GabbedT/ZenithSoC/ROADMAP.md

# ZenithSoC Roadmap 

The project will be developed using an incremental approach, structured into four distinct phases. Each phase builds upon the functionality established in the preceding step, progressively enhancing the platform capabilities. Notably, these phases are designed to be modular, allowing for any configuration to operate independently without dependency on subsequent additions. Here’s the phased development plan:

## Roadmap 

* Implement successfully in FPGA ✅
* Run real benchmark on it ✅
* Run Fractal with VGA output ✅
* Run DOOM?

### Project Structure

* Delete relative path and substitute with .f file ✅
* Add CPU cosimulation with Spike ✅

* Update documentation on ZenithSoC and ApogeoRV

* Update examples

### Testing

* Improve Python generator ✅

* Add a verilator testbench for fast software testing ✅

* Verify again every block extensively with SW driven tests thanks to Virtual Platform ✅

* Trace Unit design and verification

* C extension verification ✅
* Zfinx extension verification ✅
* CPU level test interrupts verification ✅
* SoC level interrupt verification ✅
* WFI instruction with verification
* Exception verification
* Privilege level verification

### Benchmark & Performance

* Coremark porting for SoC ✅
* Run Coremark on verilator testbench and extract performance ✅
* Embench-IoT porting for SoC ✅

* Improve performances on ApogeoRV ✅

### Bugfix

* Embench-IoT bug on huffbench as test FAIL ✅
* Fix bugs in Cache Complex ✅
* Fix C extension bugs ✅
* Fix Zfinx extension bugs ✅

### Design

* Add FENCE.I
* Add fused FPU instructions

* Add VGA ✅
* Modify ddr interface to accomodate 2 masters ✅
* Re-analyze and upgrade AXI bus
* Add external slave port for AXI bus
* Add external interrupts
* I2C design and verification
* GPU design
