GabbedT/ZenithSoC/docs/peripherals/trace_unit.rst

Trace Unit
==========

Overview
--------

The Trace Unit is a hardware module for real-time debugging and profiling of the RISC-V processor core. It monitors core execution by capturing events (exceptions, system calls, memory operations) and branch divergence (jumps, branches, calls), generating trace packets transmitted via UART for offline analysis.

The module operates non-intrusively with minimal overhead on core execution, supporting 24-bit timestamps, PC-based triggers, and configurable buffering to handle event bursts.

Features
~~~~~~~~

* CPU event tracing (exceptions, interrupts, system calls, memory operations)
* Branch divergence tracing (non-sequential control flow)
* 24-bit timestamp for temporal correlation
* Program Counter trigger for selective tracing start
* Configurable packet FIFO (32 entries in the current SoC integration)
* Automatic serialization to UART
* Core halting on buffer full to prevent data loss
* Interrupt on buffer full/empty

Architecture
------------

The Trace Unit consists of three main modules:

* **Registers**: Manages configuration, control and status registers
* **Packetizer**: Generates trace packets from CPU events and divergence detection
* **Serializer**: Serializes packets into byte stream to UART

Signal interface
~~~~~~~~~~~~~~~~

Port directions are relative to the ``trace_unit`` module. The register
signals are the local SoC memory-mapped interface, while the CPU and UART
signals are sideband interfaces. Addresses are 2-bit word indices and
``write_strobe_i`` enables individual bytes of ``write_data_i``.

.. list-table:: Trace Unit module signals
   :header-rows: 1
   :widths: 32 12 14 42

   * - Signal
     - Direction
     - Width
     - Description
   * - ``clk_i``
     - Input
     - 1
     - System clock.
   * - ``rst_n_i``
     - Input
     - 1
     - Active-low reset.
   * - ``write_i`` / ``read_i``
     - Input
     - 1 each
     - Register write and read requests.
   * - ``write_address_i[1:0]`` / ``read_address_i[1:0]``
     - Input
     - 2 each
     - Word indices in the Trace Unit register window.
   * - ``write_data_i[31:0]``
     - Input
     - 32
     - Register write data.
   * - ``write_strobe_i[3:0]``
     - Input
     - 4
     - Byte write enables.
   * - ``write_done_o`` / ``read_done_o``
     - Output
     - 1 each
     - Register transaction completion responses.
   * - ``write_error_o`` / ``read_error_o``
     - Output
     - 1 each
     - Invalid register access responses.
   * - ``interrupt_o``
     - Output
     - 1
     - Configured buffer interrupt request.
   * - ``halt_core_o``
     - Output
     - 1
     - Stops the CPU while the packet buffer is full.
   * - ``trace_interface_i``
     - Input
     - Interface
     - CPU trace bundle: ``valid``, ``address[31:0]`` and ``info``.
   * - ``uart_tx_full_i``
     - Input
     - 1
     - Backpressure from the UART TX FIFO.
   * - ``trace_chunk_o[7:0]``
     - Output
     - 8
     - Serialized trace byte sent to the UART.
   * - ``write_chunk_o``
     - Output
     - 1
     - One-cycle valid/write strobe for ``trace_chunk_o``.

Operation
---------

Packet Types
~~~~~~~~~~~~

The packetizer stores a fixed 64-bit packet internally. The serializer sends
the most-significant byte first (``raw[7]`` through ``raw[0]``), and emits only
the bytes required by the packet type. Protocol v2 prefixes every packet with
``0x1E`` (ASCII Record Separator). Within the packet body, ``0x1E`` and ``0x1D``
are escaped as ``0x1D`` followed by the original byte XOR ``0x20``. The UART
applies the same escaping to CPU console bytes, so unescaped ``0x1E`` is reserved
for trace synchronization. Packet bodies are serialized atomically; a separate
CPU queue retains concurrent console writes subject to its normal full flag.

The byte layouts below describe unescaped bodies, excluding the sync prefix.
The two most-significant bits of body byte 0 identify the packet type:

.. list-table:: Packet type codes
   :header-rows: 1
   :widths: 20 18 62

   * - Code
     - Name
     - Meaning
   * - ``2'b00``
     - ``EVENT_PACKET``
     - A selected CPU event identified by the six-bit event number.
   * - ``2'b01``
     - ``DIVERGENCE_PACKET``
     - A non-sequential PC transition.
   * - ``2'b10``
     - ``OVERFLOW_PACKET``
     - The 24-bit timestamp counter wrapped.
   * - ``2'b11``
     - ``START_PACKET``
     - Absolute initial PC or a new branch tracing session.

Start packet
^^^^^^^^^^^^

When branch tracing first accepts a valid PC (matching the trigger if enabled),
it queues a START before subsequent divergence packets. Disabling and re-enabling
branch tracing rearms START. Its body is always five bytes, without a timestamp:

.. code-block:: text

   byte 0: 11000000 (0xC0)
   byte 1..4: absolute PC[31:0], most-significant byte first

The last-reported-PC reference changes only when a START or divergence packet
is accepted into the packet FIFO. Sequential retired instructions do not change
this reference. They still update the separate previous-retired-PC register used
to detect divergences. Event-only tracing does not emit START packets.

Event packet
^^^^^^^^^^^^

The event number is copied from ``trace_interface_i.info``. The timestamp is
the 24-bit packetizer counter at packet creation time. The byte layout on the
UART stream is:

.. code-block:: text

   Without timestamp (1 byte):
   byte 0: [7:6] packet type = 00 | [5:0] event number

   With timestamp (4 bytes):
   byte 0: [7:6] packet type = 00 | [5:0] event number
   byte 1: timestamp[23:16]
   byte 2: timestamp[15:8]
   byte 3: timestamp[7:0]

Divergence packet
^^^^^^^^^^^^^^^^^

The packetizer compares the current valid PC with the previous valid PC. The
``delta_pc`` field is the signed 32-bit two's-complement value
``current_pc - last_reported_pc``. ``last_reported_pc`` is the address represented
by the preceding successfully queued START/divergence packet, not the previous
retired instruction. The byte layout is:

.. code-block:: text

   Without timestamp (5 bytes):
   byte 0: [7:6] packet type = 01 | [5:0] reserved = 0
   byte 1: delta_pc[31:24]
   byte 2: delta_pc[23:16]
   byte 3: delta_pc[15:8]
   byte 4: delta_pc[7:0]

   With timestamp (8 bytes):
   byte 0: [7:6] packet type = 01 | [5:0] reserved = 0
   byte 1..4: delta_pc[31:0], most-significant byte first
   byte 5: timestamp[23:16]
   byte 6: timestamp[15:8]
   byte 7: timestamp[7:0]

Overflow packet
^^^^^^^^^^^^^^^

The overflow packet is one byte:

.. code-block:: text

   byte 0: [7:6] packet type = 10 | [5:0] reserved = 0

It is queued when the timestamp reaches ``24'hFFFFFF``. If an event or
divergence packet is created in the same cycle, that packet has priority and
the overflow notification is held pending for a later cycle.

Timestamp framing
^^^^^^^^^^^^^^^^^

The serializer's ``enable_timestamp_i`` input is the OR of the event and
branch timestamp controls. Therefore, when either timestamp control is set,
both event and divergence packets are serialized with their three-byte
timestamp field. The timestamp is still present in the internal packet when
timestamping is disabled; it is simply omitted from the UART stream.

Event Tracing
~~~~~~~~~~~~~

When enabled, the Trace Unit captures configurable events from the core:

* **Instruction faults**: Misaligned, access fault, illegal instruction
* **Breakpoint**: Debug breakpoint
* **Load/Store operations**: Memory operations and related faults
* **System calls**: User-mode and machine-mode ecall
* **Handler return**: MRET instruction
* **Sleep**: WFI instruction
* **Branch/Jump**: Control flow operations
* **CSR operations**: Control Status Register accesses

Branch Tracing
~~~~~~~~~~~~~~

The module compares the current PC with the previous one. If it is not
``previous_pc + 4``, ``previous_pc + 2`` for a compressed instruction, or the
same PC, it generates a divergence packet containing the PC delta.

Divergence detection activates after START is queued for the first valid PC
(or the trigger PC). Packet priority is START, divergence, event, then overflow.
Only one packet is queued per cycle, so a coincident event may be suppressed.

Timestamp
~~~~~~~~~

The 24-bit counter increments every cycle when timestamping is enabled. Upon reaching 0xFFFFFF, it generates an Overflow Packet and continues from 0.

Trigger PC
~~~~~~~~~~

When enabled, branch tracing starts only when the core reaches the specified PC. Useful for tracing specific code sections.

Core Halting
~~~~~~~~~~~~

When the buffer is full, the ``halt_core_o`` signal is asserted to stop the core and prevent packet loss. The core resumes when buffer space becomes available.

Serializer FSM
--------------

The serializer uses IDLE, SYNC, DATA and ESCAPED states. IDLE reads the
synchronous packet FIFO. SYNC latches that packet, snapshots its body length
and emits ``0x1E``. DATA emits ordinary body bytes or ``0x1D`` for a reserved
byte; ESCAPED emits that byte XOR ``0x20``. It returns to IDLE after the last
body byte. UART backpressure preserves the current byte and state.

START always has five body bytes. OVERFLOW has one. EVENT has one or four;
DIVERGENCE has five or eight, according to the timestamp enable OR. Timestamp
settings must remain stable throughout a capture because no mode flag is sent.
The trace status empty flag includes serializer activity as well as the FIFO,
so software cannot mistake an in-flight packet for a fully drained trace buffer.

Register Map
------------

+--------+----------------+------+-----------------------------------------------+
| Offset | Register       | R/W  | Description                                   |
+========+================+======+===============================================+
| 0x00   | STATUS         | R    | Status register (buffer full/empty)           |
+--------+----------------+------+-----------------------------------------------+
| 0x04   | CONTROL        | R/W  | Control register (enable tracing, interrupts) |
+--------+----------------+------+-----------------------------------------------+
| 0x08   | EVENT_ENABLE   | R/W  | Event enable mask                             |
+--------+----------------+------+-----------------------------------------------+
| 0x0C   | PC_TRIGGER     | R/W  | Trigger PC value                              |
+--------+----------------+------+-----------------------------------------------+

Register Descriptions
~~~~~~~~~~~~~~~~~~~~~

**STATUS (Offset: 0x00)**

+--------+-------------+-----+-----------------------------------------------+
| Bit    | Field       | R/W | Description                                   |
+========+=============+=====+===============================================+
| 0      | BUFFER_EMPTY| R   | Buffer empty (1 = empty, 0 = data present)    |
+--------+-------------+-----+-----------------------------------------------+
| 1      | BUFFER_FULL | R   | Buffer full (1 = full, 0 = space available)   |
+--------+-------------+-----+-----------------------------------------------+
| 31:2   | Reserved    | R   | Reserved (read as 0)                          |
+--------+-------------+-----+-----------------------------------------------+

*Reset Value:* 0x00000001 (buffer empty)

**CONTROL (Offset: 0x04)**

+--------+------------------------+-----+-----------------------------------------------+
| Bit    | Field                  | R/W | Description                                   |
+========+========================+=====+===============================================+
| 0      | ENABLE_EVENT_TRACING   | R/W | Enable event tracing                          |
+--------+------------------------+-----+-----------------------------------------------+
| 1      | ENABLE_BRANCH_TRACING  | R/W | Enable branch divergence tracing              |
+--------+------------------------+-----+-----------------------------------------------+
| 2      | ENABLE_TIMESTAMP_EVENT | R/W | Include timestamp in event packets            |
+--------+------------------------+-----+-----------------------------------------------+
| 3      | ENABLE_TIMESTAMP_BRANCH| R/W | Include timestamp in divergence packets       |
+--------+------------------------+-----+-----------------------------------------------+
| 4      | ENABLE_TRIGGER         | R/W | Enable PC trigger for branch tracing          |
+--------+------------------------+-----+-----------------------------------------------+
| 5      | CLEAR_TIMESTAMP        | W   | Clear timestamp counter (self-clearing)       |
+--------+------------------------+-----+-----------------------------------------------+
| 6      | ENABLE_INT_FULL        | R/W | Enable interrupt on buffer full               |
+--------+------------------------+-----+-----------------------------------------------+
| 7      | ENABLE_INT_EMPTY       | R/W | Enable interrupt on buffer empty              |
+--------+------------------------+-----+-----------------------------------------------+
| 31:8   | Reserved               | R   | Reserved (read as 0)                          |
+--------+------------------------+-----+-----------------------------------------------+

*Reset Value:* 0x00000000

**EVENT_ENABLE (Offset: 0x08)**

18-bit mask to enable specific events. Each bit corresponds to an event:

+--------+-----------------------+-----+---------------+-----------------------------------------------+
| Bit    | Event                 | R/W | Event Number  | Description                                   |
+========+=======================+=====+===============+===============================================+
| 0      | INSTR_MISALIGNED      | R/W | 0             | Instruction address misaligned                |
+--------+-----------------------+-----+---------------+-----------------------------------------------+
| 1      | INSTR_ACCESS_FAULT    | R/W | 1             | Instruction access fault                      |
+--------+-----------------------+-----+---------------+-----------------------------------------------+
| 2      | INSTR_ILLEGAL         | R/W | 2             | Illegal instruction                           |
+--------+-----------------------+-----+---------------+-----------------------------------------------+
| 3      | BREAKPOINT            | R/W | 3             | Breakpoint exception                          |
+--------+-----------------------+-----+---------------+-----------------------------------------------+
| 4      | LOAD_OPERATION        | R/W | 19            | Load operation executed                       |
+--------+-----------------------+-----+---------------+-----------------------------------------------+
| 5      | LOAD_MISALIGNED       | R/W | 4             | Load address misaligned                       |
+--------+-----------------------+-----+---------------+-----------------------------------------------+
| 6      | LOAD_ACCESS_FAULT     | R/W | 5             | Load access fault                             |
+--------+-----------------------+-----+---------------+-----------------------------------------------+
| 7      | STORE_OPERATION       | R/W | 18            | Store operation executed                      |
+--------+-----------------------+-----+---------------+-----------------------------------------------+
| 8      | STORE_MISALIGNED      | R/W | 6             | Store address misaligned                      |
+--------+-----------------------+-----+---------------+-----------------------------------------------+
| 9      | STORE_ACCESS_FAULT    | R/W | 7             | Store access fault                            |
+--------+-----------------------+-----+---------------+-----------------------------------------------+
| 10     | U_SYSTEM_CALL         | R/W | 8             | User-mode system call (ecall)                 |
+--------+-----------------------+-----+---------------+-----------------------------------------------+
| 11     | M_SYSTEM_CALL         | R/W | 11            | Machine-mode system call (ecall)              |
+--------+-----------------------+-----+---------------+-----------------------------------------------+
| 12     | HANDLER_RETURN        | R/W | 17            | Interrupt handler return (mret)               |
+--------+-----------------------+-----+---------------+-----------------------------------------------+
| 13     | SLEEP                 | R/W | 16            | Core sleep (WFI)                              |
+--------+-----------------------+-----+---------------+-----------------------------------------------+
| 14     | BRANCH                | R/W | 20            | Branch instruction executed                   |
+--------+-----------------------+-----+---------------+-----------------------------------------------+
| 15     | JUMP                  | R/W | 21            | Jump instruction executed                     |
+--------+-----------------------+-----+---------------+-----------------------------------------------+
| 16     | CSR                   | R/W | 22            | CSR operation                                 |
+--------+-----------------------+-----+---------------+-----------------------------------------------+
| 31:17  | Reserved              | R   | -             | Reserved (read as 0)                          |
+--------+-----------------------+-----+---------------+-----------------------------------------------+

*Reset Value:* 0x00000000

**PC_TRIGGER (Offset: 0x0C)**

+--------+-------+-----+-----------------------------------------------+
| Bit    | Field | R/W | Description                                   |
+========+=======+=====+===============================================+
| 31:0   | VALUE | R/W | Program Counter trigger value                 |
+--------+-------+-----+-----------------------------------------------+

*Reset Value:* 0x00000000

Timing Characteristics
----------------------

* **Timestamp resolution**: 1 clock cycle
* **Timestamp range**: 0 to 16,777,215 cycles (24-bit)
* **Packet generation latency**: 1 clock cycle
* **Serialization rate**: Limited by UART TX speed
* **Buffer depth**: Configurable (32 packets in the current SoC integration)

For a 50 MHz clock:

* **Timestamp resolution**: 20 ns
* **Timestamp overflow**: ~335 ms
* **Max sustained event rate**: Depends on UART baud rate

Integration Guidelines
----------------------

UART Connection
~~~~~~~~~~~~~~~

The Trace Unit connects directly to the UART TX buffer. The ``uart_tx_full_i`` signal handles backpressure when UART cannot accept data.

Core Halting
~~~~~~~~~~~~

When the buffer is full, ``halt_core_o`` stops the core to prevent packet loss. Ensure the core supports halting via this signal.

Buffer Sizing
~~~~~~~~~~~~~

Buffer size must be chosen based on:

* Expected event rate
* UART baud rate
* Core halting tolerance

A larger buffer reduces core halt probability but increases latency and area.

Packet Parsing
~~~~~~~~~~~~~~

1. Route bytes outside frames to the console, reversing console escapes.
2. On unescaped ``0x1E``, begin a trace packet and reverse body escapes.
3. Obtain the body length from its type and the configured timestamp mode.
4. START establishes the absolute PC. Add each divergence delta modulo 2^32
   to the last reported PC; resolve that address through an ELF if available.
5. Events have no address and do not update the PC reference.
6. An unexpected sync byte can recover framing after corruption. Invalidate
   the PC reference until a new START because a missing delta cannot be inferred.

This reconstructs reported PC samples, not every retired instruction. START has
no timestamp. Without a checksum or sequence number, some corruption and loss of
whole packets cannot be detected. Capture before firmware enables branch tracing
to receive START; an already running stream may require tracing to be restarted.
Legacy unframed v1 captures use a different decoder and delta reference.

Limitations
-----------

* 24-bit timestamp (overflow after ~335 ms at 50 MHz)
* Fixed buffer size at synthesis time
* No packet compression
* Single trace interface (only one core supported)
* Shared UART console/trace requires a v2-aware decoder (legacy captures remain v1)
* Core halting on buffer full may impact real-time timing
