GabbedT/ZenithSoC/fpga/nexys_a7/README.md

# Nexys A7 DDR Vivado flow

The batch flow targets the Digilent Nexys A7 DDR 100T
(`xc7a100tcsg324-1`) with Vivado 2024.1.

```bash
cd fpga/nexys_a7
make project       # create the project and regenerate IP
make retry-synth   # rerun RTL synthesis while reusing generated IP
make retry-impl    # rerun implementation from the synthesized checkpoint
make finish-routed # write reports/bitstream from an existing routed checkpoint
make synth         # synthesize
make impl          # place and route
make bitstream     # generate build/vivado/ZenithSoC_nexys_a7.bit
make update-bootloader # patch a new bootloader into an existing bitstream
make sim           # run the accurate MIG + DDR2 + SD-card XSim testbench
make sim_gui       # open the simulation in the Vivado GUI
make wave          # open the captured waveform database in XSim
```

To open the project manually, use `build/vivado/project/ZenithSoC.xpr` after
running `make project`. In Vivado select **Simulation Sources**, verify
`soc_testbench` as the simulation top, then choose **Run Simulation > Run
Behavioral Simulation**. The generated project now contains the MIG, DDR2,
SD-card model, testbench, and SD image in `sim_1`.

The simulation target uses the generated clock wizard and MIG controller, the
Micron DDR2 component model in `tb/ddr_model`, and the SD-card model maintained
in `vp/blocks/sd/rtl`.  Testbench sources are added explicitly to the Vivado
simulation fileset; `SoC_testbench.sv` therefore contains no source includes or
machine-specific paths.  The default simulated interval is 1 ms and can be
overridden, for example:

```bash
make sim SIM_RUNTIME=5ms JOBS=8
```

For the VGA fractal image, build the application and pass both generated
initialization files explicitly:

```bash
make -C sw/examples/vga VGA_DEMO=fractal RESOLUTION=320x240 all
make -C fpga/nexys_a7 sim SIM_RUNTIME=20ms JOBS=4 \
    VIVADO=/tools/Xilinx/2026.1/Vivado/bin/vivado \
    BOOTLOADER_HEX=../../sw/examples/vga/out/boot.hex \
    SD_IMAGE_HEX=../../sw/examples/vga/out/vga_fractal_sd_words.hex
```

The VGA Makefile converts `program.bin` to one 32-bit hexadecimal word per
line for the SD-card model. The simulation Tcl stages the selected boot image
under the canonical `bootloader.hex` name expected by the SoC ROM and adds the
selected SD image to the XSim memory fileset.

`make sim_gui` uses the same project and waveform setup but leaves the
simulation open for interactive use.  After a batch run, `make wave` creates a
curated waveform configuration and opens the captured database; it requires a
previous `make sim` run. Preferrebly one should do a `make sim_gui`, add the required signals
and save the waveform file, then exit and execute `make sim`.

The XSim project, log, waveform database, and trace files are written below
`build/vivado/simulation/`.  The simulation define set intentionally includes
`_VIVADO_` and excludes `VERILATOR`, so `ZenithSoC` instantiates the real MIG
path rather than its fast behavioural DDR replacement.

The simulation depends on the boot image and sine-table
initialization file configured in `project_config.tcl`, from here change the bootloader hex path.  Build those images
before running XSim if they are not already present.

Override the executable when Vivado is not on `PATH`:

```bash
make bitstream VIVADO=/tools/Xilinx/Vivado/2024.1/bin/vivado
```

Reports and generated files are written below `build/vivado/`.

The flow uses `Flow_PerfOptimized_high` for synthesis and
`Performance_ExplorePostRoutePhysOpt` for implementation. The strategy's
timing-driven `Explore` directives are kept as the default, including the
post-route physical optimization pass; alternate directives are available
through the sweep targets below.

The main implementation reports are:

- `timing_impl.rpt`: timing summary and clock-domain details;
- `failing_paths_impl.rpt`: the 500 worst setup paths;
- `utilization_impl.rpt`: device utilization;
- `bus_skew_impl.rpt`: MIG bus-skew checks;
- `drc_impl.rpt`: design-rule checks.

The system clock is 100 MHz and the MIG input clock is 200 MHz. The DDR2
interface runs with a 3333 ps memory period and a 2:1 PHY/controller ratio.

## Updating only the bootloader

A full `make bitstream` generates both the base bitstream and
`build/vivado/bootloader.mmi`. The MMI records the placed locations of the four
block RAMs that form the 16 KiB boot memory. The flow is not tied to CoreMark;
the CoreMark paths are only defaults. To build a base bitstream with any boot
program, provide its byte-oriented initialization file:

```bash
make bitstream BOOTLOADER_HEX=/absolute/path/to/bootloader.hex
```

The update target is independent of the software project. If the ELF has
already been built, pass it directly:

```bash
make update-bootloader BOOTLOADER_ELF=/absolute/path/to/bootloader.elf
```

To rebuild it first, also specify its Make directory and, optionally, its Make
target:

```bash
make update-bootloader \
    BOOTLOADER_ELF=/absolute/path/to/project/out/bootloader.elf \
    BOOTLOADER_BUILD_DIR=/absolute/path/to/project \
    BOOTLOADER_BUILD_TARGET=bootloader
```

`BOOTLOADER_BUILD_TARGET` can be omitted to run the software project's default
target. With no overrides, the default CoreMark ELF is rebuilt through its
`fpga` target. Other projects use the same mechanism by overriding the three
variables shown above. If UpdateMEM produces an unchanged configuration
payload, the command prints a warning that the ELF may be stale.

The target atomically updates the deployable
`build/vivado/ZenithSoC_nexys_a7.bit` with `updatemem`; synthesis, placement,
and routing are not repeated. A full bitstream build also writes the preserved
`build/vivado/ZenithSoC_nexys_a7_base.bit`, which is used as the source for
later bootloader updates. Override the tool or output path with
`UPDATEMEM=/path/to/updatemem` or `BOOTLOADER_BIT=/path/to/output.bit`.

The two bootloader files have different roles:

- `bootloader.hex` is a byte-oriented initialization file read by
  `$readmemh` while Vivado synthesizes the inferred boot RAM. It determines the
  contents of a newly implemented base bitstream.
- `bootloader.elf` contains the same program plus its load-address metadata.
  UpdateMEM uses those addresses with `bootloader.mmi` to modify only the boot
  RAM initialization data in an existing bitstream.

Run a full `make bitstream` again after RTL, constraints, FPGA part, boot-memory
size, or implementation settings change. The regenerated MMI is tied to that
specific placed bitstream.

### 100 MHz timing closure and the floorplan

The flow targets 100 MHz with a coarse floorplan in
`../../constraint/floorplan.xdc`. It is applied at implementation only
(`USED_IN_SYNTHESIS false`), so editing the regions does not invalidate the
synthesis run. Three pblocks are pinned on the 7a100t die:

* `pblock_cpu` — the ApogeoRV complex against its BRAM/DSP columns
  (`SLICE_X0Y9:SLICE_X55Y110`), with `CONTAIN_ROUTING`.
* `pblock_mig` — the fabric-based DDR controller to the right
  (`SLICE_X56Y20:SLICE_X89Y128`), with `CONTAIN_ROUTING`.
* `pblock_apu` — the audio processing unit at the top
  (`SLICE_X0Y50:SLICE_X59Y199`), without `CONTAIN_ROUTING`: the dense
  wave-mixer adder trees left 107 pins unrouted under containment.

`fpga/nexys_a7/pblock/` holds the site lists used to visualize each region in
the Vivado GUI — open the routed checkpoint and source
`pblock/pblock_cpu_RangedSites.tcl` (and the `*_AllTiles.tcl` /
`*_FrameTiles.tcl` variants) to highlight a region.

### When a feature does not meet timing

Synthesis is reused across floorplan iterations, so the loop is a single
command:

```bash
make retry-impl        # ~15-18 min, reuses synth_1
```

The outcome is in `build/vivado/timing_impl.rpt` (Design Timing Summary:
WNS/TNS, failing endpoints) and `build/vivado/failing_paths_impl.rpt`
("No timing paths found." when clean). Diagnose before touching anything:

1. **Classify the failures.** In the worst paths, compute the route share
   (route delay over total delay). The original 500 failures were all
   route-dominated (44-78%): logic depth was within budget, so the fix was
   placement, not RTL.
2. **Route-dominated** → tune the floorplan: enlarge the pblock that owns the
   source/destination module in `../../constraint/floorplan.xdc`, then `retry-impl`.
   Regions are oversized ~2-3x on purpose — keep them generous. Note that
   `resize_pblock -add` takes one corner-to-corner rectangle
   (`{SLICE_X0Y9:SLICE_X55Y110}`): a space-separated list creates many
   single-site regions instead.
3. **Logic-dominated** → an RTL problem: no floorplan can fix excessive logic
   depth. It needs a pipeline/latency change and must be reviewed as a CPU
   change — do not hide it under a bigger pblock.
4. **Search implementation settings before changing RTL.** The current best
   recorded result uses `Performance_ExplorePostRoutePhysOpt` and reports
   WNS=-0.227 ns, TNS=-6.677 ns, with 77 failing setup endpoints. The worst
   path is 74.5% routing delay, so this is still primarily a placement/route
   problem. A strategy comparison can be run with:

   ```bash
   make sweep-impl SWEEP_CONFIGS="baseline explore_postroute_physopt explore"
   ```

   Empty per-step directives are reset between candidates; each candidate
   also writes `timing_sweep_<name>.rpt` and
   `failing_paths_sweep_<name>.rpt` below `build/vivado/`.

   For a faster experiment after routing, compare post-route physical
   optimization directives from the same checkpoint:

   ```bash
   make postroute-sweep POSTROUTE_DIRECTIVES="Explore AggressiveExplore"
   ```

   Those reports and checkpoints are kept under
   `build/vivado/timing_search/`; the script never promotes a candidate
   bitstream automatically. Forced driver replication remains an opt-in
   diagnostic (`make physopt-repl`) because the measured result regressed to
   WNS=-1.018 ns.

5. **Do not weaken the 100 MHz constraint.** If implementation search still
   leaves a negative WNS after the floorplan is verified, an RTL pipeline
   change needs separate CPU review and cosimulation. Leave margin for process
   corner variation before shipping a new feature.
