GabbedT/ZenithSoC/sw/examples/audio_record/waveform.png

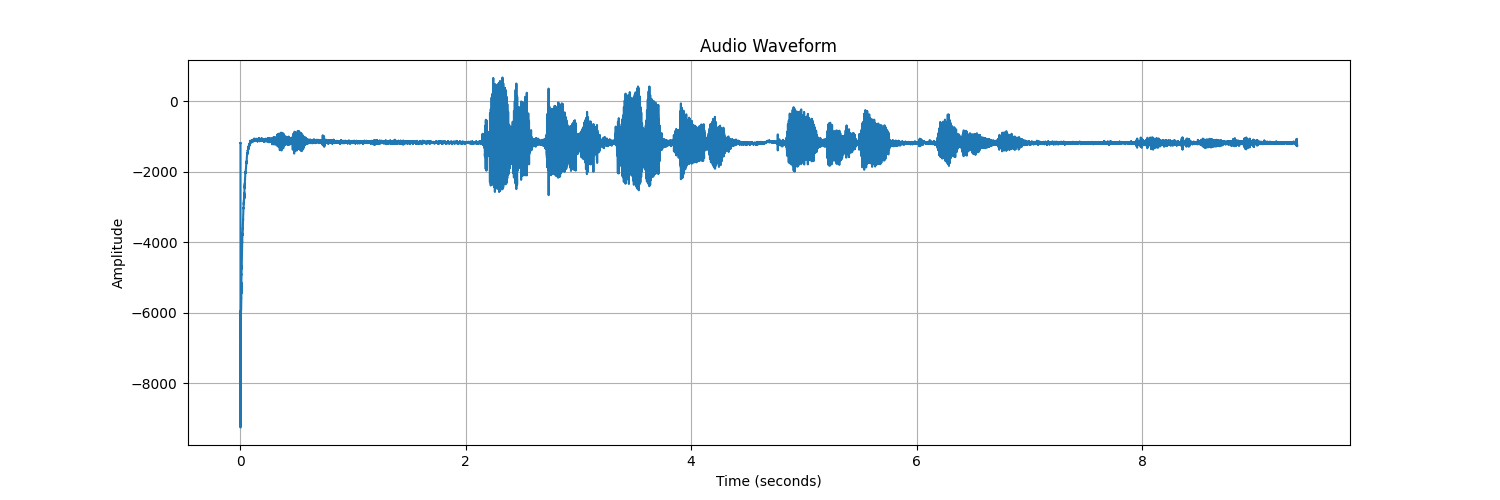
sw/examples/audio_record/waveform.png
