GabbedT/ZenithSoC/TODO.md

Problems in core during flush / stall since external caches can still be working
Halt unit included in trap manager since flush logic is there? 
Removing acknowledge interrupt?
trap manager -> sleep unit
