GabbedT/ZenithSoC/vp/common/tb/tb_top.sv

`timescale 1ns/1ns

module tb_top (
    input  logic        clk,
    input  logic        rst_n,

    input  logic        write_i,
    input  logic [31:0] write_address_i,
    input  logic [31:0] write_data_i,
    input  logic [3:0]  write_strobe_i,
    output logic        write_done_o,
    output logic        write_error_o,

    input  logic        read_i,
    input  logic [31:0] read_address_i,
    output logic [31:0] read_data_o,
    output logic        read_done_o,
    output logic        read_error_o,

    output logic        interrupt_o
);

    dut_wrapper u_dut ( .* );

endmodule
