GabbedT/ZenithSoC/hw/cpu/cpu_complex.sv

`ifndef CPU_COMPLEX_SV
    `define CPU_COMPLEX_SV

module cpu_complex #(
    /* Predictor table size */ 
    parameter PREDICTOR_SIZE = 512, 

    /* Branch target buffer cache size */
    parameter BTB_SIZE = 512, 

    /* Store buffer entries number */
    parameter STORE_BUFFER_SIZE = 4, 

    /* Maximum number of instruction held by the buffer */
    parameter INSTRUCTION_BUFFER_SIZE = 8,

    /* Reorder Buffer entries */
    parameter ROB_DEPTH = 32,

    /* Data cache parameters */
    parameter DCACHE_SIZE = 2**12,
    parameter DBLOCK_SIZE_BYTE = 16,

    /* Instruction cache parameters */
    parameter ICACHE_SIZE = 2**12,
    parameter IBLOCK_SIZE_BYTE = 16
) (
    input logic clk_i,
    input logic rst_n_i,
    input logic halt_i,

    /* Trace channel */
    trace_interface.master trace_channel,
    
    /* Boot ROM interface */
    fetch_interface.master rom_fetch_channel,

    /* Cache to DDR channels */
    load_interface.master ddr_load_channel, 
    store_interface.master ddr_store_channel,

    /* MMIO channels */
    load_interface.master io_load_channel, 
    store_interface.master io_store_channel,

    /* Store transaction is not burst */
    output logic single_strx_o,
    output logic instr_load_o,

    /* Room for load requests */
    input logic ldr_ready_i,
    input logic str_ready_i,

    /* Interrupts */
    input logic gen_interrupt_i,
    input logic nmsk_interrupt_i,
    input logic timer_interrupt_i, 
    input logic [7:0] interrupt_vector_i,
    output logic interrupt_ackn_o
);

//====================================================================================
//      PROCESSOR
//====================================================================================

    logic interrupt_ff, timer_interrupt_ff, nmsk_interrupt_ff; logic [7:0] vector_ff;

        always_ff @(posedge clk_i `ifdef ASYNC or negedge rst_n_i `endif) begin
            if (!rst_n_i) begin
                interrupt_ff <= 1'b0;
                timer_interrupt_ff <= 1'b0;
                nmsk_interrupt_ff <= 1'b0;
                vector_ff <= 8'b0;
            end else begin
                interrupt_ff <= gen_interrupt_i;
                timer_interrupt_ff <= timer_interrupt_i;
                nmsk_interrupt_ff <= nmsk_interrupt_i;
                vector_ff <= interrupt_vector_i;
            end
        end

    /* CPU channels */
    fetch_interface cpu_fetch_channel(); 
    load_interface cpu_load_channel();
    store_interface cpu_store_channel();

    logic cache_flush_request;
    logic cache_flush_pending;
    logic dcache_flush_busy, dcache_flush_done;
    logic icache_flush_busy, icache_flush_done;

        always_ff @(posedge clk_i `ifdef ASYNC or negedge rst_n_i `endif) begin
            if (!rst_n_i) begin
                cache_flush_pending <= 1'b0;
            end else if (cache_flush_request) begin
                cache_flush_pending <= 1'b1;
            end else if (dcache_flush_done) begin
                cache_flush_pending <= 1'b0;
            end
        end


    logic core_flush_busy;
    assign core_flush_busy = cache_flush_request | cache_flush_pending | dcache_flush_busy;

    /* Core instantiation */
    ApogeoRV #(PREDICTOR_SIZE, BTB_SIZE, STORE_BUFFER_SIZE, INSTRUCTION_BUFFER_SIZE, ROB_DEPTH) system_cpu (
        .clk_i    ( clk_i   ),
        .rst_n_i  ( rst_n_i ),

        .halt_i   ( halt_i ),
        .halted_o (        ),

        .flush_o      ( cache_flush_request ),
        .flush_busy_i ( core_flush_busy     ),

        .trace_channel ( trace_channel ),

        .fetch_channel ( cpu_fetch_channel ), 

        .interrupt_i        ( interrupt_ff       ), 
        .non_maskable_int_i ( nmsk_interrupt_ff  ),
        .timer_interrupt_i  ( timer_interrupt_ff ), 
        .interrupt_vector_i ( vector_ff          ),
        .interrupt_ackn_o   ( interrupt_ackn_o   ),

        .load_channel  ( cpu_load_channel  ), 
        .store_channel ( cpu_store_channel )
    );

    assign rom_fetch_channel.fetch = cpu_fetch_channel.fetch & (cpu_fetch_channel.address <= `BOOT_END);
    assign rom_fetch_channel.address = cpu_fetch_channel.address;
    assign rom_fetch_channel.invalidate = cpu_fetch_channel.invalidate;


//====================================================================================
//      DATA CACHE
//====================================================================================

    load_interface dcache_load_channel();
    store_interface dcache_store_channel();

    load_interface cached_io_load_channel();

    assign io_load_channel.address = cached_io_load_channel.address;
    assign io_load_channel.request = cached_io_load_channel.request;
    assign io_load_channel.invalidate = cached_io_load_channel.invalidate;

        /* Keep AXI response routing outside the CPU wakeup path. */
        always_ff @(posedge clk_i `ifdef ASYNC or negedge rst_n_i `endif) begin : io_response_register
            if (!rst_n_i) begin
                cached_io_load_channel.valid <= 1'b0;
            end else if (cached_io_load_channel.invalidate) begin
                cached_io_load_channel.valid <= 1'b0;
            end else begin
                cached_io_load_channel.valid <= io_load_channel.valid;
            end
        end : io_response_register

        always_ff @(posedge clk_i) begin
            if (io_load_channel.valid) begin
                cached_io_load_channel.data <= io_load_channel.data;
            end
        end

    logic stall_data;
    
    data_cache_complex #(DCACHE_SIZE, DBLOCK_SIZE_BYTE) dcache (
        .clk_i   ( clk_i      ),
        .rst_n_i ( rst_n_i    ),
        .stall_i ( stall_data ),

        .flush_i       ( cache_flush_request ),
        .flush_ready_i ( str_ready_i         ),
        .flush_busy_o  ( dcache_flush_busy   ),
        .flush_done_o  ( dcache_flush_done   ),

        .single_trx_o ( single_strx_o ),

        /* Load unit interface */
        .ldu_channel ( cpu_load_channel ),

        /* Store unit interface */
        .stu_channel ( cpu_store_channel ),

        /* DDR Memory load interface */
        .ddr_load_channel ( dcache_load_channel ),

        /* DDR  Memory store interface */
        .ddr_store_channel ( dcache_store_channel ),

        /* I/O Memory load interface */
        .io_load_channel ( cached_io_load_channel ),

        /* I/O  Memory store interface */
        .io_store_channel ( io_store_channel )
    );

    assign ddr_store_channel.address = dcache_store_channel.address - `USER_MEMORY_REGION_START;
    assign ddr_store_channel.data = dcache_store_channel.data;
    assign ddr_store_channel.request = dcache_store_channel.request;
    assign ddr_store_channel.width = dcache_store_channel.width;

    assign dcache_store_channel.done = ddr_store_channel.done;


//====================================================================================
//      INSTRUCTION CACHE
//====================================================================================

    logic stall_fetch, region_switch;

    load_interface icache_load_channel();
    fetch_interface icache_fetch_channel();

    instruction_cache_complex #(ICACHE_SIZE, IBLOCK_SIZE_BYTE) icache (
        .clk_i           ( clk_i                       ), 
        .rst_n_i         ( rst_n_i                     ),
        .stall_i         ( stall_fetch                 ),
        .region_switch_i ( region_switch               ),
        .conflict_i      ( dcache_load_channel.request ),

        .flush_i      ( 1'b0              ),
        .flush_busy_o ( icache_flush_busy   ),
        .flush_done_o ( icache_flush_done   ),

        /* Fetch unit interface */
        .fetch_channel ( icache_fetch_channel ),

        /* Memory load interface */ 
        .load_channel ( icache_load_channel )
    );

    assign icache_fetch_channel.fetch = cpu_fetch_channel.fetch
                                      & (cpu_fetch_channel.address >= `USER_MEMORY_REGION_START);
    assign icache_fetch_channel.address = cpu_fetch_channel.address;
    assign icache_fetch_channel.invalidate = cpu_fetch_channel.invalidate;


        always_comb begin
            cpu_fetch_channel.valid = rom_fetch_channel.valid | icache_fetch_channel.valid;
            cpu_fetch_channel.stall = rom_fetch_channel.stall | icache_fetch_channel.stall;

            case ({rom_fetch_channel.valid, icache_fetch_channel.valid})
                2'b01: cpu_fetch_channel.instruction = icache_fetch_channel.instruction;

                default: cpu_fetch_channel.instruction = rom_fetch_channel.instruction;
            endcase
        end


    logic rom_region;

        always_ff @(posedge clk_i `ifdef ASYNC or negedge rst_n_i `endif) begin
            if (!rst_n_i) begin 
                rom_region <= 1'b1;
            end else begin 
                if (rom_fetch_channel.fetch) begin
                    rom_region <= 1'b1;
                end else if (icache_fetch_channel.fetch) begin
                    rom_region <= 1'b0;
                end
            end 
        end 

    /* ROM region to DDR region */
    assign region_switch = rom_region & icache_fetch_channel.fetch;


//====================================================================================
//      LOAD CHANNEL ARBITER
//====================================================================================

    localparam ICACHE = 1'b0;
    localparam DCACHE = 1'b1;


        always_comb begin : request_arbiter
            /* Default value */
            ddr_load_channel.address = '0;
            instr_load_o = 1'b0;

            case ({icache_load_channel.request, dcache_load_channel.request})
                2'b11, 2'b01: begin
                    /* Data cache has more priority */
                    ddr_load_channel.address = dcache_load_channel.address - `USER_MEMORY_REGION_START;
                end

                2'b10: begin
                    ddr_load_channel.address = icache_load_channel.address - `USER_MEMORY_REGION_START;

                    instr_load_o = 1'b1;
                end
            endcase

            ddr_load_channel.request = icache_load_channel.request | dcache_load_channel.request;
            ddr_load_channel.invalidate = icache_load_channel.invalidate | dcache_load_channel.invalidate;
        end : request_arbiter

    logic priority_bit, valid_stall;


    localparam MAX_REFILL_WORDS = ((DBLOCK_SIZE_BYTE > IBLOCK_SIZE_BYTE) ? DBLOCK_SIZE_BYTE : IBLOCK_SIZE_BYTE) / 4;
    localparam BURST_COUNT_WIDTH = $clog2(MAX_REFILL_WORDS + 1);
    
    /* Include the complete burst count. Wrapping an eight-word request to
     * zero would release ownership before its first response arrives. */
    logic [BURST_COUNT_WIDTH - 1:0] burst_req_count, burst_resp_count;
    logic burst_active;

        always_ff @(posedge clk_i `ifdef ASYNC or negedge rst_n_i `endif) begin
            if (!rst_n_i) begin
                priority_bit <= ICACHE;
                valid_stall <= 1'b0;
                burst_active <= 1'b0;
                burst_req_count <= '0;
                burst_resp_count <= '0;
            end else begin
                if (burst_active) begin
                    if (ddr_load_channel.request) begin
                        burst_req_count <= burst_req_count + 1'b1;
                    end

                    if (ddr_load_channel.valid) begin
                        burst_resp_count <= burst_resp_count + 1'b1;
                    end

                    /* Burst done: request line idle and every requested
                     * word answered. The owner keeps the port until then. */
                    if (!ddr_load_channel.request & (burst_resp_count == burst_req_count)) begin
                        valid_stall <= 1'b0;
                        burst_active <= 1'b0;
                    end
                end

                if (ddr_load_channel.request & !valid_stall) begin
                    /* request_arbiter selects the data-cache address when both
                     * caches request a refill. Latch the same selection so
                     * the returning burst is routed to the data cache. */
                    priority_bit <= dcache_load_channel.request;

                    valid_stall <= 1'b1;
                    burst_active <= 1'b1;

                    /* This cycle already carries the first requested word */
                    burst_req_count <= 1;
                    burst_resp_count <= '0;
                end
            end
        end

    assign stall_data = valid_stall & !priority_bit;

    assign stall_fetch = valid_stall & priority_bit;


        /* Drain every refill beat, including invalidated transactions. */
        always_ff @(posedge clk_i `ifdef ASYNC or negedge rst_n_i `endif) begin : response_arbiter
            if (!rst_n_i) begin
                dcache_load_channel.valid <= 1'b0;
                icache_load_channel.valid <= 1'b0;
            end else begin
                dcache_load_channel.valid <= ddr_load_channel.valid & (priority_bit == DCACHE);
                icache_load_channel.valid <= ddr_load_channel.valid & (priority_bit == ICACHE);
            end
        end : response_arbiter

        always_ff @(posedge clk_i) begin
            if (ddr_load_channel.valid) begin
                dcache_load_channel.data <= ddr_load_channel.data;
                icache_load_channel.data <= ddr_load_channel.data;
            end
        end


//====================================================================================
//      ASSERTIONS
//====================================================================================

    `ifdef SV_ASSERTION
        assert property (@(posedge clk_i) disable iff (!rst_n_i)
            {dcache_load_channel.valid, icache_load_channel.valid} ==
            $past({ddr_load_channel.valid & (priority_bit == DCACHE),
                   ddr_load_channel.valid & (priority_bit == ICACHE)}));

        assert property (@(posedge clk_i) disable iff (!rst_n_i)
            (dcache_load_channel.valid | icache_load_channel.valid) |->
            (dcache_load_channel.data == $past(ddr_load_channel.data)) &
            (icache_load_channel.data == $past(ddr_load_channel.data)));

        assert property (@(posedge clk_i) disable iff (!rst_n_i)
            cached_io_load_channel.valid ==
            $past(io_load_channel.valid & !cached_io_load_channel.invalidate));
    `endif

endmodule : cpu_complex

`endif
