GabbedT/ZenithSoC/(commit log)

2023-11-03 Fixed bugs, added slave address match and assertions
    [axi_slave.sv]
2023-11-03 Fixed bugs and added assertions
    [axi_master.sv]
2023-11-15 Added UART IO Core
2023-11-17 Added flow control enable
2023-11-17 Added board UART test
2023-11-17 Modified UART status register
2023-11-17 Added UART doc
2023-11-18 Updated UART documentation
2023-11-18 Added interrupt controller
2023-11-18 Added Timer
2023-11-18 Fixed parity error bug
    [uart_receiver.sv]
2023-11-18 Added clock divider for debounce circuit
2023-11-23 AXI infrastructure fixes (timing loops, multi-driven nets)
    [axi_master.sv, axi_network.sv, axi_router.sv]
2023-11-23 Added features to timer
2023-11-29 Added invalidate input to fix load fowarding from store buffer
    [axi_master.sv]
2023-11-29 Added C++ driver library
2023-11-29 Added testbench program for UART
2023-12-03 Fixed bug on get value
    [GPIO.cpp]
2023-12-03 Added pin set
2023-12-17 Parametrized interrupts and devices number
2023-12-17 Added SPI device
2023-12-17 Fixed bug on status register
    [uart_registers.sv]
2023-12-17 Fixed UART bugs
2023-12-17 Added SPI package
2023-12-17 Added MMIO SPI address
2023-12-17 Added SPI header
2023-12-17 Added SPI source code
2023-12-20 SPI Library update
2024-01-06 Added PWM empty files
2024-02-09 Added 200us PHY reset logic
    [ethernet_reset.sv]
2024-02-09 Fixed TX and RX logic
    [ethernet_rx.sv, ethernet_tx.sv]
2024-02-09 Added reset on store pending
    [on_chip_memory.sv]
2024-02-09 Ethernet driver added
2024-02-28 Added support for 10Mbps, CRSDV loss recovery and fixed CRC calculation
    [ethernet_rx.sv]
2024-02-28 Added input synchronizer, bootstrap mode at reset and fixed clock generation
    [ethernet.sv]
2024-02-28 Changed SPI idle line
2024-02-28 Driver update
2024-03-11 Added SerialOut class for debug print using UART
2024-03-11 Disabled interrupt on initialization
2024-03-20 Update driver
2024-03-24 Added SPI example program for ADXL362 Accelerometer
2024-05-16 Added system cache, verified and fixed data cache
    [block_bank.sv, data_block.sv, data_cache.sv, data_cache_complex.sv, fetch_controller.sv, instruction_block.sv, instruction_cache.sv, instruction_cache_complex.sv]
2024-05-16 Fixed write / read
    [asynchronous_buffer.sv]
2024-06-17 Traces added
2024-09-19 Added stall logic
2024-09-19 Sequencer fixed, added region switch logic and changed the interface
    [instruction_cache_complex.sv]
2024-09-19 Added stall logic to resolve ICACHE collisions
    [load_controller.sv, store_controller.sv]
2024-09-19 Added stall and region switch logic
    [fetch_controller.sv]
2024-09-19 Fixed bugs related to bursts
    [cache_ddr_interface.sv]
2024-09-19 Fixed bugs related to interface MIG
    [ddr_memory_interface.sv]
2024-09-19 Trace files
2024-09-19 Added PRNG driver
2024-09-19 Added default arguments in UART driver
2024-10-18 Fixed file paths and stop condition bug
    [SoC_testbench.sv]
2024-11-01 Added IO Trace file for printing
2024-11-10 Modified DDR pin names, fixed bug on Non Cachable Memory writes and bug on SPI interrupt
    [ZenithSoC.sv]
2024-11-10 Fixed bug on parameter, exponential was a multiplication
    [soc_parameters.sv]
2024-11-10 Removed fused instructions from compilation
2024-11-10 Added process script that divides the output file in different files for each test case
2024-11-10 Changed printf argument
2024-11-10 Fixed typos and added explicit conversions
    [SerialOut.cpp]
2024-11-30 Clock driving error fixed
    [ZenithSoC.sv]
2024-11-30 Fixed timing related to CDC
    [ddr_memory_interface.sv]
2024-11-30 Filter and PCM generator added for PDM to PCM module
2024-11-30 Testbench for CIC filter and post processor added
2024-12-12 Renamed CIC Filter
2024-12-12 Added software driver for PDM2PCM module
2024-12-30 Updated filter order and decimation factor width
2024-12-30 Fixed unwanted change on cache address
    [store_controller.sv]
2024-12-30 Fixed stall logic
2025-01-06 Sampled interrupts to improve timing
2025-02-01 Fixed bug on Ethernet TX which skipped a byte for each transaction
    [ethernet_tx.sv]
2025-02-01 Removed debug prints
2025-02-13 Added AudioSynthesizer driver
2025-02-13 Fixed AXI addresses for APU
    [ZenithSoC.sv]
2025-03-02 Update boot size and APU device space parameters
2025-03-02 Fix base address in AudioCapture to use APU_BASE instead of ACU_BASE
    [AudioCapture.cpp]
2025-03-02 Enhance vprintf to support floating point precision and fix format error handling
    [Serial_IO.cpp]
2025-03-02 Update simulation time and clean up reset logic in SoC testbench
    [SoC_testbench.sv]
2025-04-07 Update load controller to handle stall conditions in cache read and address generation
    [load_controller.sv]
2025-04-07 Update APU device space and non-cachable memory base address in soc_parameters
2025-07-09 Update TODO list: add verification for FPU, test interrupts, and refine sine wave generator path
2025-07-27 Add SD package with control, status, and interrupt status register definitions
2025-07-27 Add SD driver header file with control, status, and interrupt register definitions
2025-07-27 Remove unnecessary private access specifiers in driver header files to make the classes more flexible
2025-09-18 Fix bit counter condition in sd_command_controller to correctly handle response waiting
    [sd_command_controller.sv]
2025-09-18 Add reset_done input and modify control register logic for card reset handling
    [sd_registers.sv]
2025-09-18 Add reset_done signal and update reset logic in SD module
    [sd.sv]
2025-09-18 Implement cache locking mechanism to prevent out-of-order transactions on shared cache addresses
    [data_cache_complex.sv]
2025-09-18 Add SD card test functionality and boot setup
    - Implemented sd_test.cpp to perform read and write tests on SD cards, including burst operations and performance measurements.
    - Added setup.s to initialize the boot process, configure interrupts, and copy the program from ROM to RAM before jumping to the sd_test function.
2025-09-18 Refactor SD.h: Remove unused interrupt sources and reorganize card information structure
2025-09-18 Add SD.cpp: Implement SD card driver with initialization, command handling, and data transfer functions
2026-04-29 Fixed Timer function
2026-04-29 Added initial trace unit files
2026-04-29 Added core halt and uart full signals
2026-04-29 Modified UART interface
2026-05-03 Add trace unit testbench with comprehensive tracing tasks and control logic
2026-05-04 Refactor event register logic to use current event_register values instead of control_register
2026-05-04 Enhance SD driver to include CRC error handling in response methods
    [SD.cpp]
2026-05-05 Add requirements.txt for IO Devices documentation
2026-05-05 Rename Docs/IO Devices/requirements.txt to Docs/requirements.txt
2026-05-09 Remove obsolete documentation for Ethernet, GPIO, SPI, Timer, and UART modules
    - Deleted the entire documentation for the Ethernet module, which included details on RMII interface, MAC, and PHY controller.
    - Removed GPIO documentation covering its overview, features, and register descriptions.
    - Eliminated SPI documentation detailing its operation, features, and register map.
    - Cleared Timer documentation that described its functionality and register layout.
    - Purged UART documentation outlining its features, architecture, and register descriptions.
2026-05-09 Refactor event generation logic and enhance overflow handling in trace unit packetizer
2026-05-10 Add trace unit integration with CPU and memory interfaces
2026-05-10 Add trace unit parameters and integrate trace channel in CPU complex module
2026-05-10 Implement TraceUnit class with control, status, and event handling functionality
2026-05-12 Add flushTX control and improve writeBlock/writeBurst handling in SD driver
2026-05-15 Refactor UART status register assignments to use always_ff for synchronous updates
2026-05-16 Added timer for VP
2026-05-16 Modified makefile to use external libraries of IO devices
2026-06-08 Fixed bugs on SD controller thanks to SW driven test with Virtual Platform
    [sd.sv, sd_command_controller.sv, sd_data_controller.sv, sd_pkg.sv, sd_registers.sv]
2026-06-08 Modified software interface and fixed bugs
    [SD.cpp]
2026-06-13 Fixed bugs added/removed features on software library
    [AudioCapture.cpp, AudioSynthesizer.cpp, Ethernet.cpp, GPIO.cpp, PRNG.cpp, SD.cpp, SPI.cpp, Serial_IO.cpp]
2026-06-13 Added interrupt on level 1, posedge, negedge and both edges in GPIO
2026-06-13 Modified trace unit packet format, now more efficient in terms of bytes sent
2026-06-14 Timer modified
2026-06-14 Added modifications to timer
2026-06-23 Fixed typos and include in RTL files
    [soc_parameters.sv, uart.sv]
2026-06-24 Fixed SD firmware on virtual platform
    [firmware.cpp]
2026-06-24 Fixed bug on ROM interface and naming typo
    [ZenithSoC.sv, cpu_complex.sv]
2026-06-24 Fixed bugs on software
    [SD.cpp]
2026-06-28 Added printing the failing seeds after regression
2026-06-28 Fixed bug on memory data store
    [cosim.cpp]
2026-06-28 Fixed bug in cache due to a race condition store - load
    [store_controller.sv]
2026-06-28 Fixed bug on lock address
    [data_cache_complex.sv]
2026-06-30 Fixed lock bug on cache complex
    [data_cache_complex.sv]
2026-06-30 Fixed behavioural DDR memory
    [ZenithSoC.sv]
2026-07-02 Added UART printing
2026-07-02 Fixed bug on status TX
    [uart_registers.sv]
2026-07-03 Fixed lost store writes during cache port arbitration
    [store_controller.sv]
2026-07-07 Fixed Ctrl+C stall
2026-07-11 Added trace file generation
2026-07-12 Added configuration functions on UART
2026-07-12 Updated VP test for SD and UART
2026-07-14 Fixed single transaction store
    [cache_ddr_interface.sv]
2026-07-14 Added read to flip-flop
    [data_block.sv]
2026-07-14 Fixed data area store
    [elf_loader.h]
2026-07-14 Fixed stall read
2026-07-15 Fixed lock logic on data cache
    [data_cache_complex.sv]
2026-07-15 Remove unsupported fused FP instructions from generator
2026-07-16 Latch peripheral interrupts only on rising edges to avoid continuous interrupting
    [interrupt_controller.sv]
2026-07-16 Changed register space in GPIO and Timer to accomodate new registers
2026-07-16 Fixed drivers
2026-07-17 Added SPI to Virtual Platform
2026-07-17 Added flow control to UART test
2026-07-17 Added flow control to UART wrapper
2026-07-17 Added Timer test
2026-07-18 Fixed serializer based on new packet
    [trace_unit_serializer.sv]
2026-07-18 Fixed clock divisor in SD controller
    [sd.sv]
2026-07-18 Restored reset in initialization function
    [SD.cpp]
2026-07-18 Added trace test
2026-07-18 Added trace interface to UART
2026-07-18 Updated UART wrapper
2026-07-25 Fixed UART pin inversion
    [pins.xdc]
2026-07-26 Added bootloader update without re running Vivado flow
2026-07-26 Fixed stalling sd model
    [sd_link.v, sd_phy.v]
2026-07-26 Removed parity mode in UART init
2026-07-26 Added SD boot in driver
2026-07-30 Reset for SD is active high
    [SoC_testbench.sv, pins.xdc, zenith_tb_top.sv]
2026-07-30 CoreMark software fix/debug added
    [boot_sd.cpp, core_portme.c, core_portme.h, ee_printf_zenith.c]
2026-07-30 Fixed overflow packet description
    [trace_unit_pkg.sv]
2026-08-03 Fixed logic and added debug ILA
    [ddr_memory_interface.sv]
2026-08-09 Fixed invalidation bugs and added saved infos for next request
    [load_controller.sv]
2026-08-09 Locking mechanism fixed to accomodate two requests
    [data_cache_complex.sv]
2026-08-13 Fixed cosim for pipelined load unit
    [cosim.cpp, cosim_top.sv]
2026-08-15 Readded trace in make run in cosim/
2026-08-15 Fixed cache accesses counter
    [load_controller.sv]
2026-08-15 Fixed fetch ahead bug
    [cpu_complex.sv, fetch_controller.sv, instruction_cache_complex.sv]
2026-08-24 Updated fetch controller with two stage pipeline design
2026-08-30 Fixed unused parameters in fetch controller
    [fetch_controller.sv]
2026-09-08 Fixed lock request on replay
    [load_controller.sv]
2026-09-08 Fixed burst request logic for cache miss
    [ZenithSoC.sv, cache_ddr_interface.sv, cpu_complex.sv]
2026-09-10 Fixed assertion in load_controller
    [load_controller.sv]
2026-09-12 Fixed performance counters for new timing optimizations
    [perf_counters.sv]
2026-09-12 Fixed cosim for cache miss request for different block sizes
    [cosim_top.sv]
2026-09-13 Added logic to handle 320x240 resolution to avoid repeated fetches of same pixels
    [vga_line_buffer.sv]
2026-09-13 Fixed register module to add new / remove old config
    [vga_registers.sv]
2026-09-13 Fix VGA register layout and sprite table map
    [vga_pkg.sv]
2026-09-13 Fix line buffer pointers and remove refill logic
    [vga_line_buffer.sv]
2026-09-13 Fixed VGA counters and sprite boundaries
    [vga_controller.sv]
2026-09-13 Fixed sprite table initialization and checks
    [vga_sprite.sv]
2026-09-13 Fixed DDR response valid signal
    [ddr_master.sv]
2026-09-16 Added credit scoreboard to avoid overflow of the FIFO
    [vga_pixel_sequencer.sv]
2026-09-16 Updated VGA driver
2026-09-17 Added early frame done signal
2026-09-17 Fixed reservoir filling bug at the start of the frame
    [vga_pixel_sequencer.sv]
2026-09-17 Fixed low resolution mode output
    [vga_line_buffer.sv]
2026-09-17 Added early frame done in driver
2026-09-17 Added flush engine to frame buffer address changes to enable double buffering
2026-09-17 Updated verilator testbench with live VGA frame display
2026-09-30 Added new trace unit packet to sync with the workbench
